CoretechR/PicoLab/firmware/html/pinout_pico2.webp

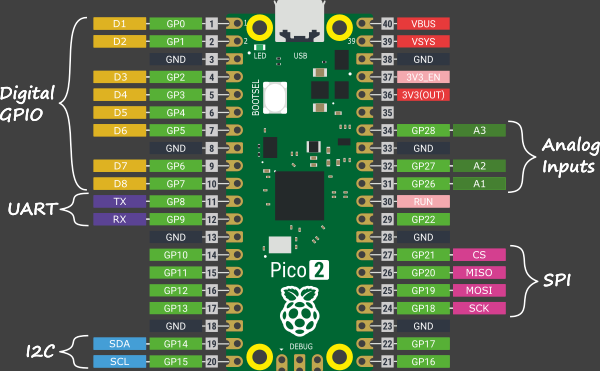
firmware/html/pinout_pico2.webp
