CoretechR/PicoLab/firmware/html/pinout_picolab.webp

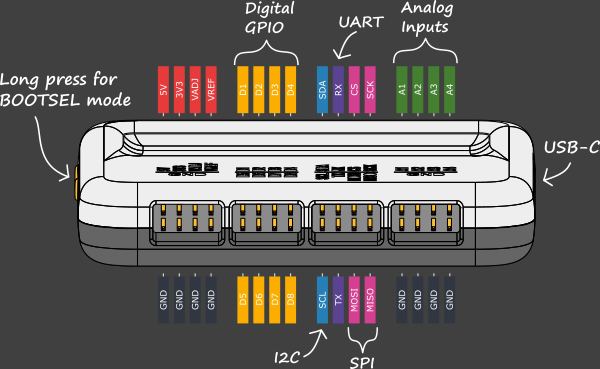
firmware/html/pinout_picolab.webp
