CoretechR/PicoLab/PCB/production/bom.csv

Designator | Footprint | Quantity | Value | LCSC Part #
C10, C11, C7, C8 | 0603 | 4 | 10nF
C12, C13, C18, C24, C27, C28, C31, C32, C33, C34, C35, C36, C37, C38, C39, C4, C40, C42, C43, C44, C45, C49, C50, C51, C52, C53, C54, C55, C56, C57, C58, C59, C60, C61, C62, C63, C64, C65, C66, C67, C68, C69, C70, C71, C72, C73, C74, C75, C76 | 0603 | 49 | 100nF | C1591
C15, C17 | 0603 | 2 | 15pF | C107037
C16, C21, C6, C9 | 0603 | 4 | 1uF | C15849
C22, C25, C26, C29 | 0603 | 4 | 4.7uF | C1705
C23, C41 | 1206 | 2 | 22uF | C91604
C46 | 1206 | 1 | 22uF
C47 | 0603 | 1 | 22nF | C106222
C48 | 0805 | 1 | 10uF
D1 | D_SOD-323 | 1 | 1N4148WS | C118873
D15 | SOT-23 | 1 | BAS70-04
D2 | LED_SK6812MINI_PLCC4_3.5x3.5mm_P1.75mm | 1 | SK6812MINI | C2886570
D3, D4, D5, D6 | SOT-23 | 4 | BAS70-04 | C54194934
D8 | D_SOD-323 | 1 | BAT54WS | C124205
F1 | 1206 | 1 | 500mA | C220146
J1 | USB_C_Receptacle_HRO_TYPE-C-31-M-12 | 1 | USB_C_Receptacle_USB2.0 | C2982555
J2 | JST_SH_SM03B-SRSS-TB_1x03-1MP_P1.00mm_Horizontal | 1 | Conn_01x03_Pin | C160403
J4, J5, J6, J7 | 10129382-908003BLF | 4 | Conn_02x04_Counter_Clockwise | C6970143
L3 | L_pol_2016 | 1 | 3.3uH | C42411119
L4 | 1008 | 1 | 4.7uH | C668313
Q10, Q15, Q16, Q17, Q18, Q4, Q6, Q8 | SOT-23 | 8 | BSS138 | C52895
Q11, Q12, Q13, Q14, Q3, Q5, Q7, Q9 | SOT-23 | 8 | DMG2301L | C7472914
R10, R11 | 0603 | 2 | 27 | C137753
R100, R101, R110, R111, R112, R113, R130, R133, R134, R138, R140, R143, R145, R148, R150, R153, R155, R158, R63, R64, R74, R77, R82, R85, R90, R93, R98, R99 | 0603 | 28 | 1M | C217860
R102, R103, R104, R105, R131, R135, R142, R147, R152, R156, R65, R75, R83, R91 | 0603 | 14 | 330
R106, R107, R108, R109, R114, R115, R116, R117, R118, R120, R122, R124, R126, R127, R128, R129, R14, R17, R27, R28, R34, R42, R46, R53, R61, R66, R67, R68, R69, R72, R76, R78, R79, R81, R84, R86, R87, R89, R9, R92, R94, R95, R97 | 0603 | 43 | 10K | C98220
R119, R121, R123, R125, R136, R139, R144, R149, R154, R159, R62, R80, R88, R96 | 0603 | 14 | 120 | C125925
R12 | 0603 | 1 | 330R | C105881
R13, R19, R22, R25 | 0603 | 4 | 300K
R15 | 0603 | 1 | 33
R16, R18, R21, R24 | 0603 | 4 | 820K
R2, R4 | 0603 | 2 | 1k | C22548
R20, R23 | 0603 | 2 | 21.5k
R26 | 0603 | 1 | 27K
R29 | 0603 | 1 | 0.5
R3, R8 | 0603 | 2 | 5.1k | C105580
R30, R31, R32, R33 | 0603 | 4 | 100 | C125923
R43, R44, R73 | 0603 | 3 | 0R03 | C422943
R49, R50 | 0603 | 2 | 4k7 | C99782
R52 | 0603 | 1 | 300K | C116699
SW1 | Panasonic_EVQPUM_EVQPUD | 1 | SW_Push | C388642
U1 | QFN-80-1EP_10x10mm_P0.4mm_EP3.4x3.4mm | 1 | RP2350_80QFN
U10 | QFN-16_3x3mm_P0.5mm_MPS | 1 | MP28167-A
U11, U4, U8 | SOT-23-5 | 3 | INA180A2 | C192764
U13, U14, U19, U20, U21, U22, U23, U24, U26, U28, U30, U31, U32, U33 | SOT-23-6 | 14 | SN74LVC1T45DBV | C7843
U15, U25, U27, U29 | SOT-23-6 | 4 | SRV05-4 | C558418
U16, U17, U18 | SOT-363_SC-70-6 | 3 | LM66100DCK | C2869734
U2 | TSSOP-14_4.4x5mm_P0.65mm | 1 | TLV9004IPWR | C2058050
U3 | WSON-8-1EP_6x5mm_P1.27mm_EP3.4x4.3mm | 1 | IS25LP064D-JKLA3-TR | C27531352
U5 | SOT-666 | 1 | USBLC6-2P6 | C2827693
U6 | SOT-23-5 | 1 | AP2112K-3.3 | C51118
U7 | SOT-23 | 1 | LM4040D30IDBZR | C130178
U9 | MSOP-8_3x3mm_P0.65mm | 1 | PI4ULS5V202 | C481697
Y1 | Crystal_SMD_Abracon_ABM8G-4Pin_3.2x2.5mm | 1 | ABM8-272-T3 | C20625731
