CoretechR/PicoLab/CAD/side_frame.stl

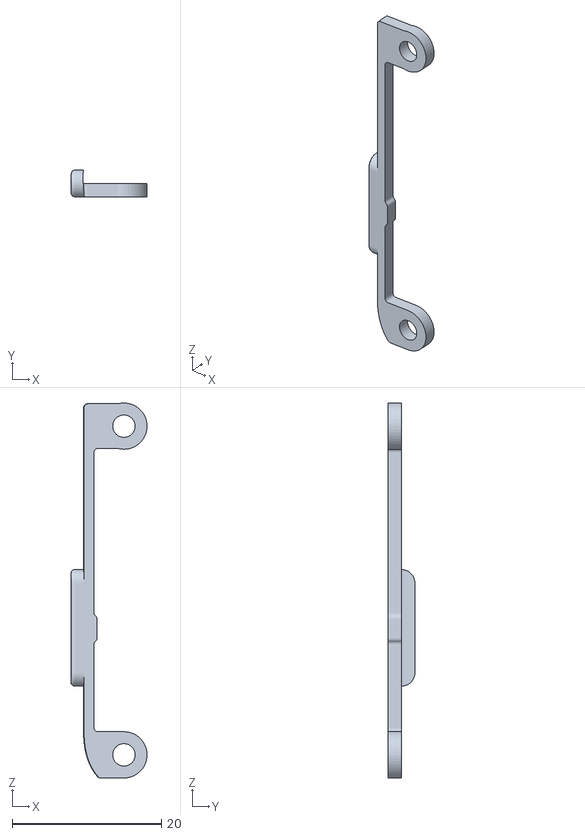
[picture p6: CAD file, 2026-10-18]
CAD/side_frame.stl
10.2 x 3.60 x 50.2
