CoretechR/PicoLab/CAD/PicoLab.step

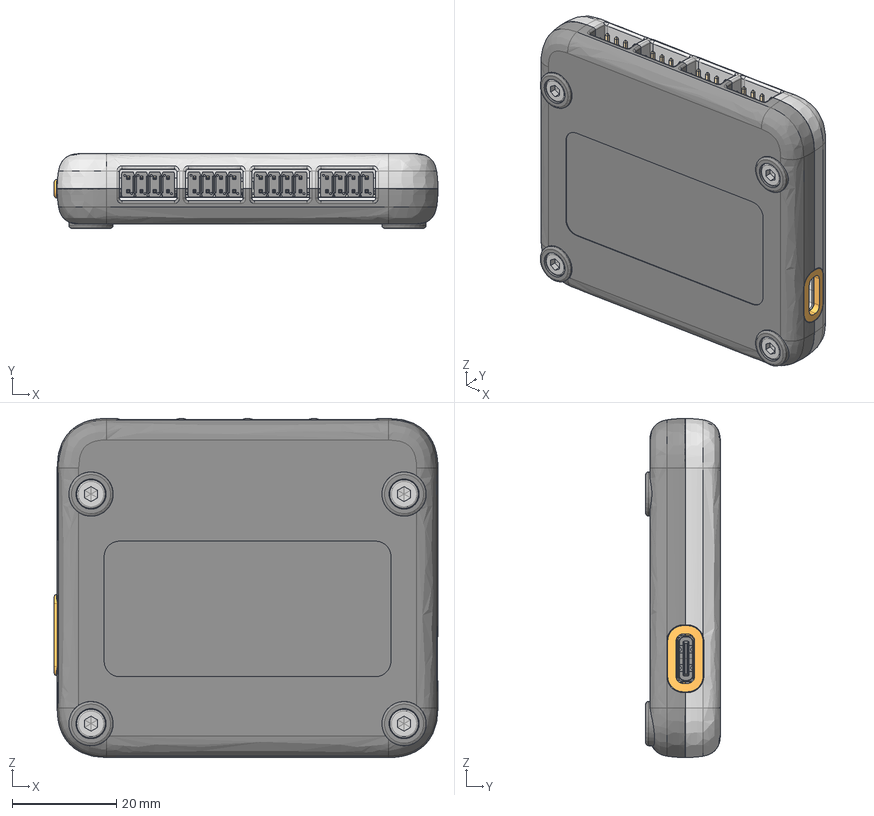
[picture p7: CAD file, 2026-10-18]
CAD/PicoLab.step
73.6 x 14.3 x 65.0 mm
BSHCS ASME B18.3.1M - M3x0.5 x 8 Stahlklasse 2 Einfach x 4
C_1206_3216Metric_1 x 3
R_0603_1608Metric_1 x 129
C_0603_1608Metric_1 x 65
USB_C_Receptacle_16P_TopMnt_Horizontal_GCT_USB4105-xx-A
QFN-16-1EP_3x3mm_P0.5mm_EP1.7x1.7mm_1
SOT-23-6_1 x 18
MSOP-8_3x3mm_P0.65mm_1
TSSOP-14_4.4x5mm_P0.65mm_1
L_Cenker_CKCS201610_1
s10129382-X08003XLF v0 x 4
SOT-363_SC-70-6_1 x 3
C_0805_2012Metric_1
WSON-8-1EP_6x5mm_P1.27mm_EP3.4x4.3mm_1
SOT-23_1 x 22
JST_SH_SM03B-SRSS-TB_1x03-1MP_P1.00mm_Horizontal_1
Crystal_SMD_Abracon_ABM8G-4Pin_3.2x2.5mm_1
SOT-23-5_1 x 4
SOT_666
Fuse_1206_3216Metric_1
D_SOD-323_1 x 2
Panasonic_EVQPUM_EVQPUD_1
rp2350text
L_1008_2520Metric_1
SK6812MINI
PicoLab_silkscreen
PicoLab_silkscreen_1
PicoLab_PCB
