CoretechR/PicoLab/PCB/project_libraries/3D-models/SK6812MINI-012.STEP

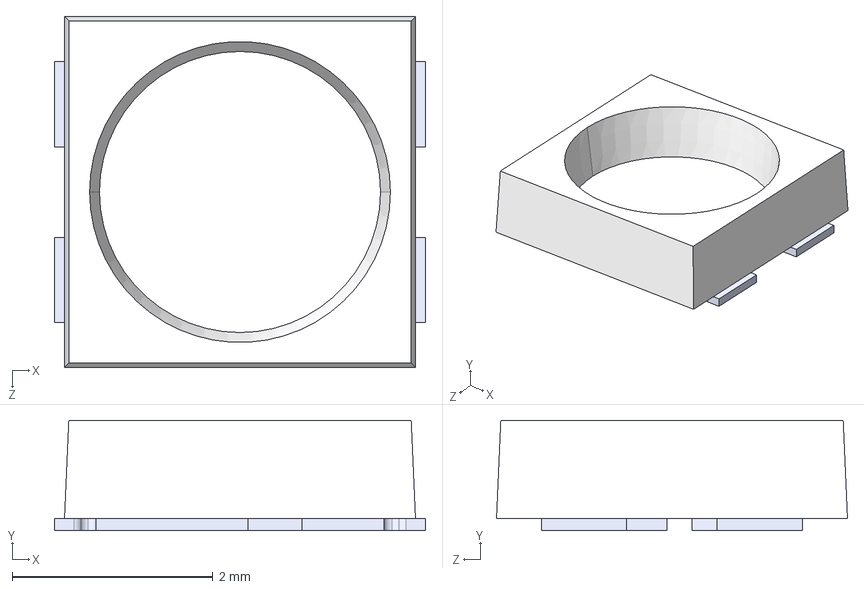
[picture p8: CAD file, 2026-10-18]
PCB/project_libraries/3D-models/SK6812MINI-012.STEP
3.70 x 1.10 x 3.50 mm
