CoretechR/PicoLab/CAD/Bottom.stl

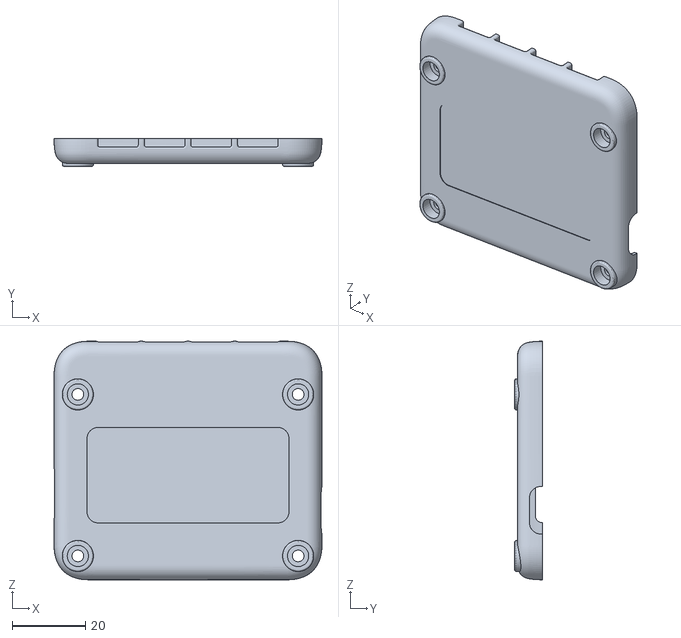
[picture p9: CAD file, 2026-10-18]
CAD/Bottom.stl
73.0 x 7.60 x 65.0
