CoretechR/PicoLab/CAD/USB_frame.stl

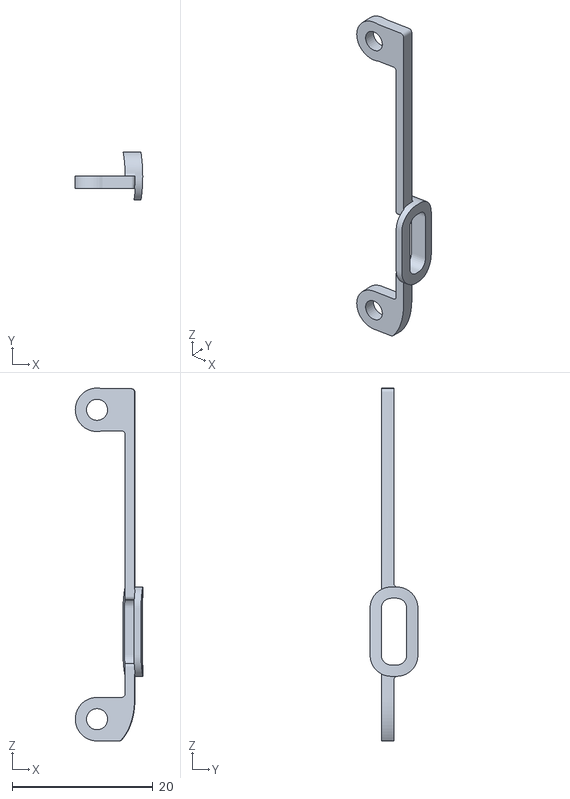
[picture p10: CAD file, 2026-10-18]
CAD/USB_frame.stl
9.60 x 6.80 x 50.2
