CoretechR/PicoLab/CAD/Top.stl

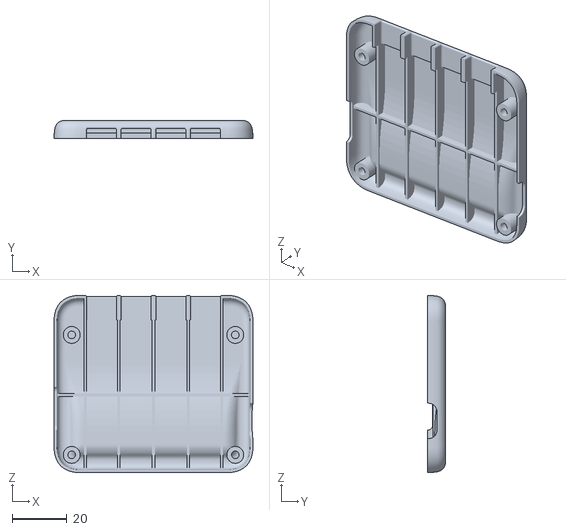
[picture p11: CAD file, 2026-10-18]
CAD/Top.stl
73.0 x 6.70 x 65.0
