CoretechR/PicoLab/PCB/project_libraries/3D-models/s10129382-X08003XLF.step

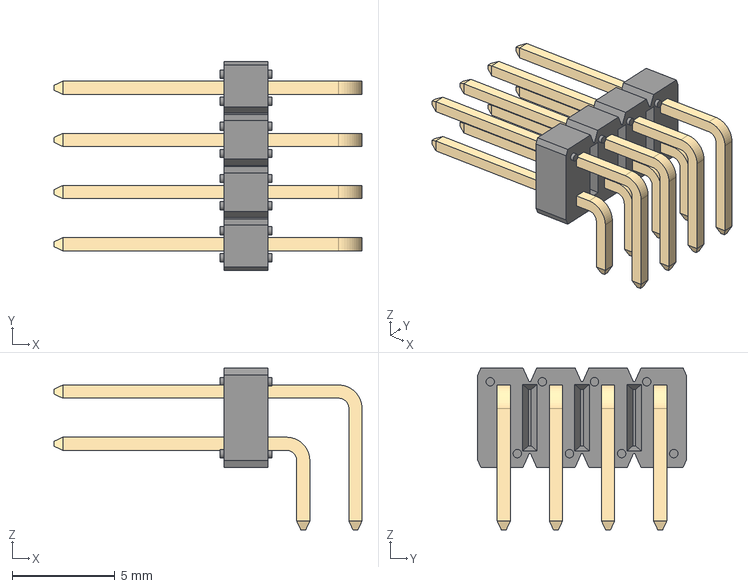
[picture p12: CAD file, 2026-10-18]
PCB/project_libraries/3D-models/s10129382-X08003XLF.step
15.0 x 10.2 x 7.88 mm
