CoretechR/PicoLab/PCB/PicoLab.pdf

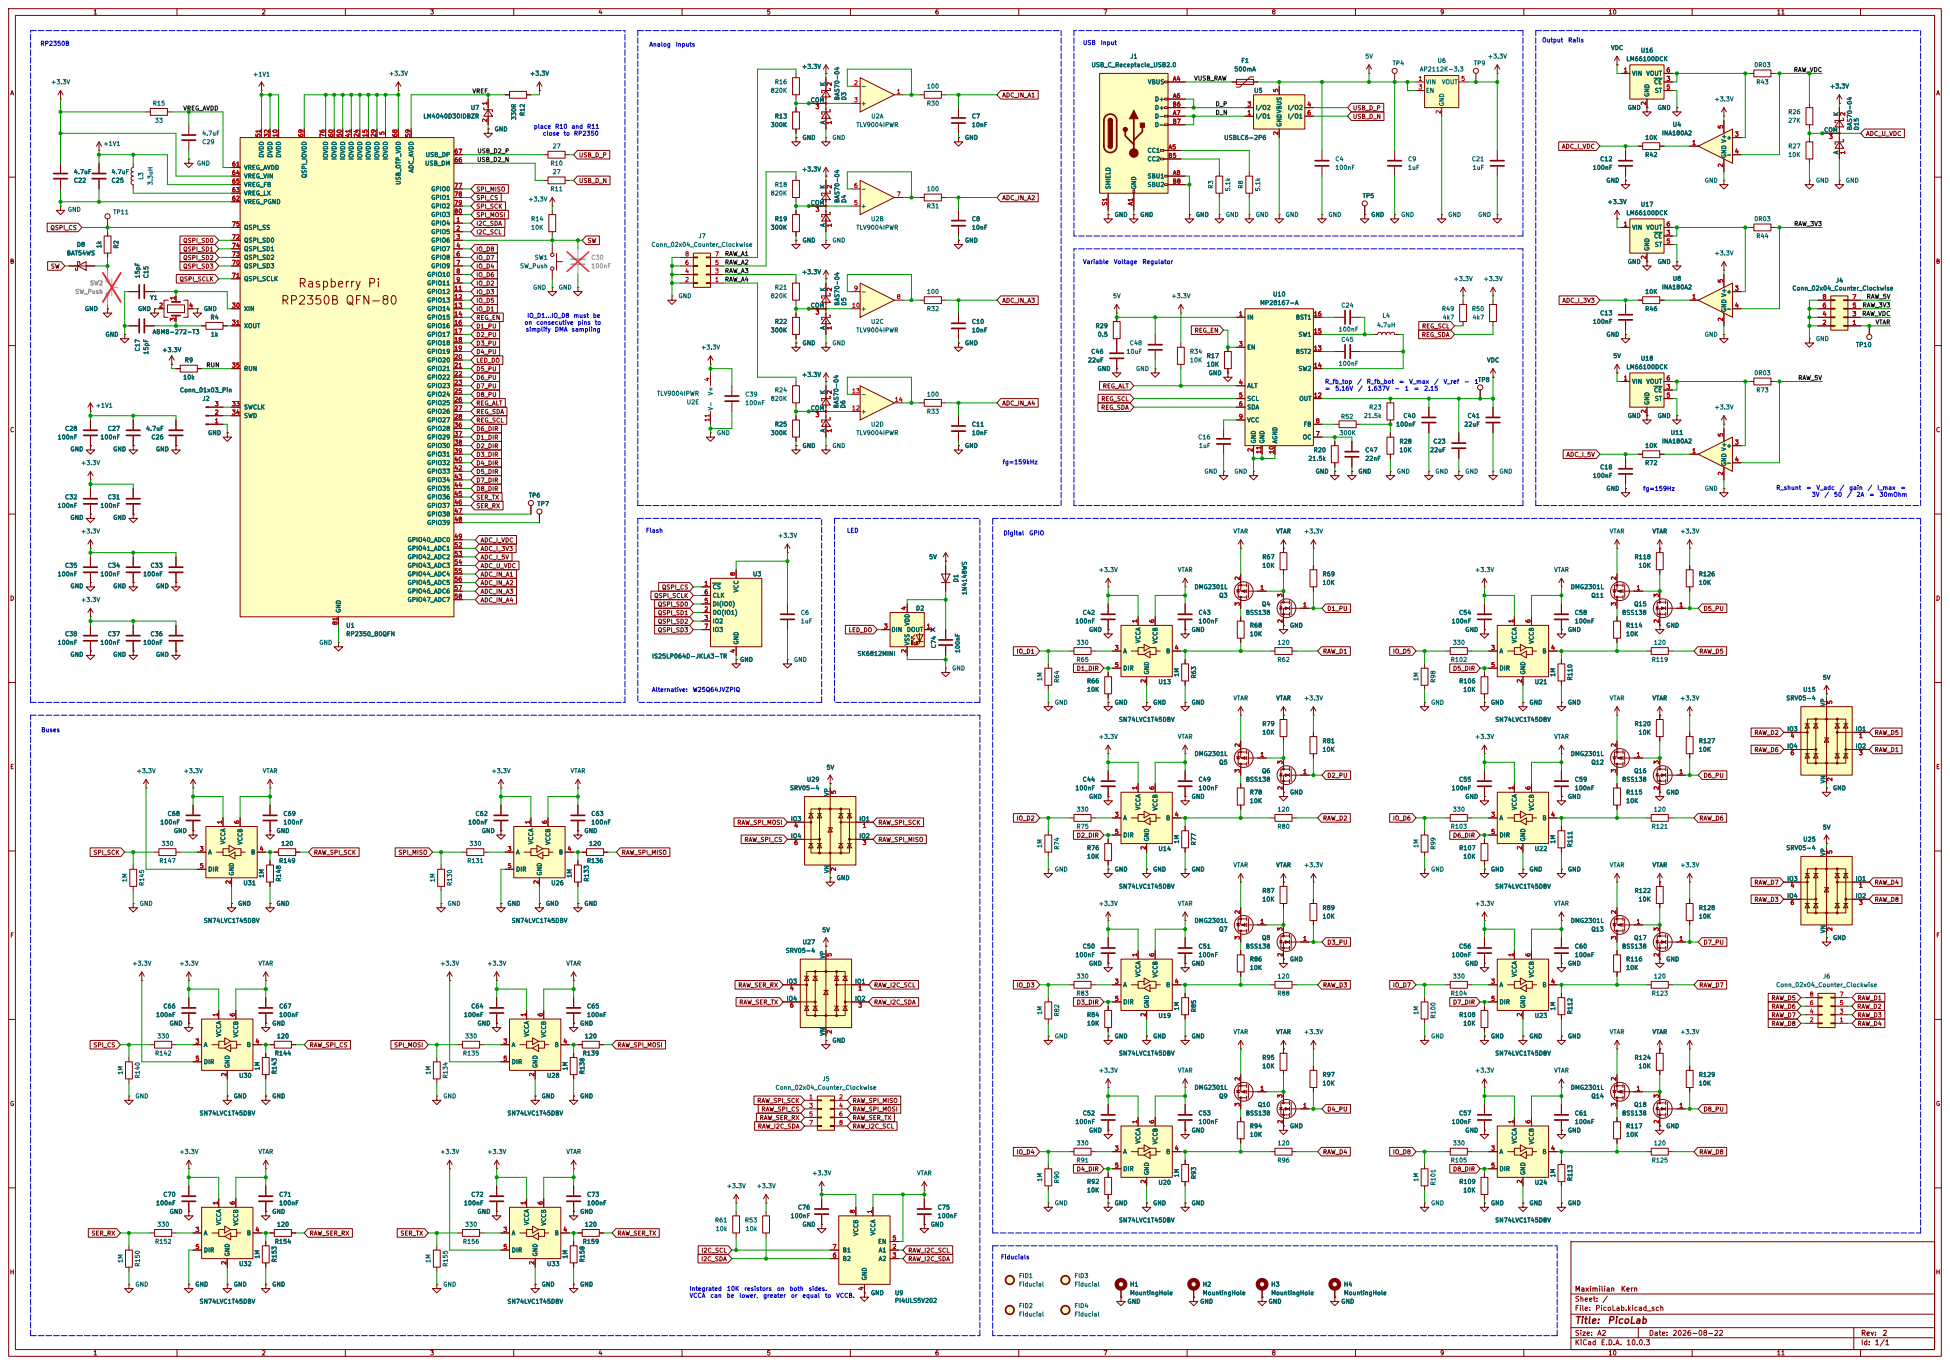
[picture p13: page 1]

5 GPIO8 6 GPIO9 7 GPIO10 8 GPIO11 9 DVDD 10 GPIO12 11 GPIO13 12 GPIO14 13 GPIO15 14 IOVDD 15 GPIO16 16 GPIO17 17 GPIO18 18 GPIO19 19 GPIO20 20 GPIO21 21 GPIO22 22 GPIO23 23 IOVDD 24 GPIO24 25 GPIO25 26 GPIO26 27 GPIO27 28 IOVDD 29

IO_D1...IO_D8 must be on consecutive pins to

Integrated 10K resistors on both sides. VCCA can be lower, greater or equal to VCCB.

GND | GND

Size: A2 | Rev: 2
KiCad E.D.A. 10.0.3 | Id: 1/1
