CoretechR/PicoLab/PCB/PicoLab.kicad_pcb

## KiCad design PCB/PicoLab.kicad_pcb (2026-10-18)

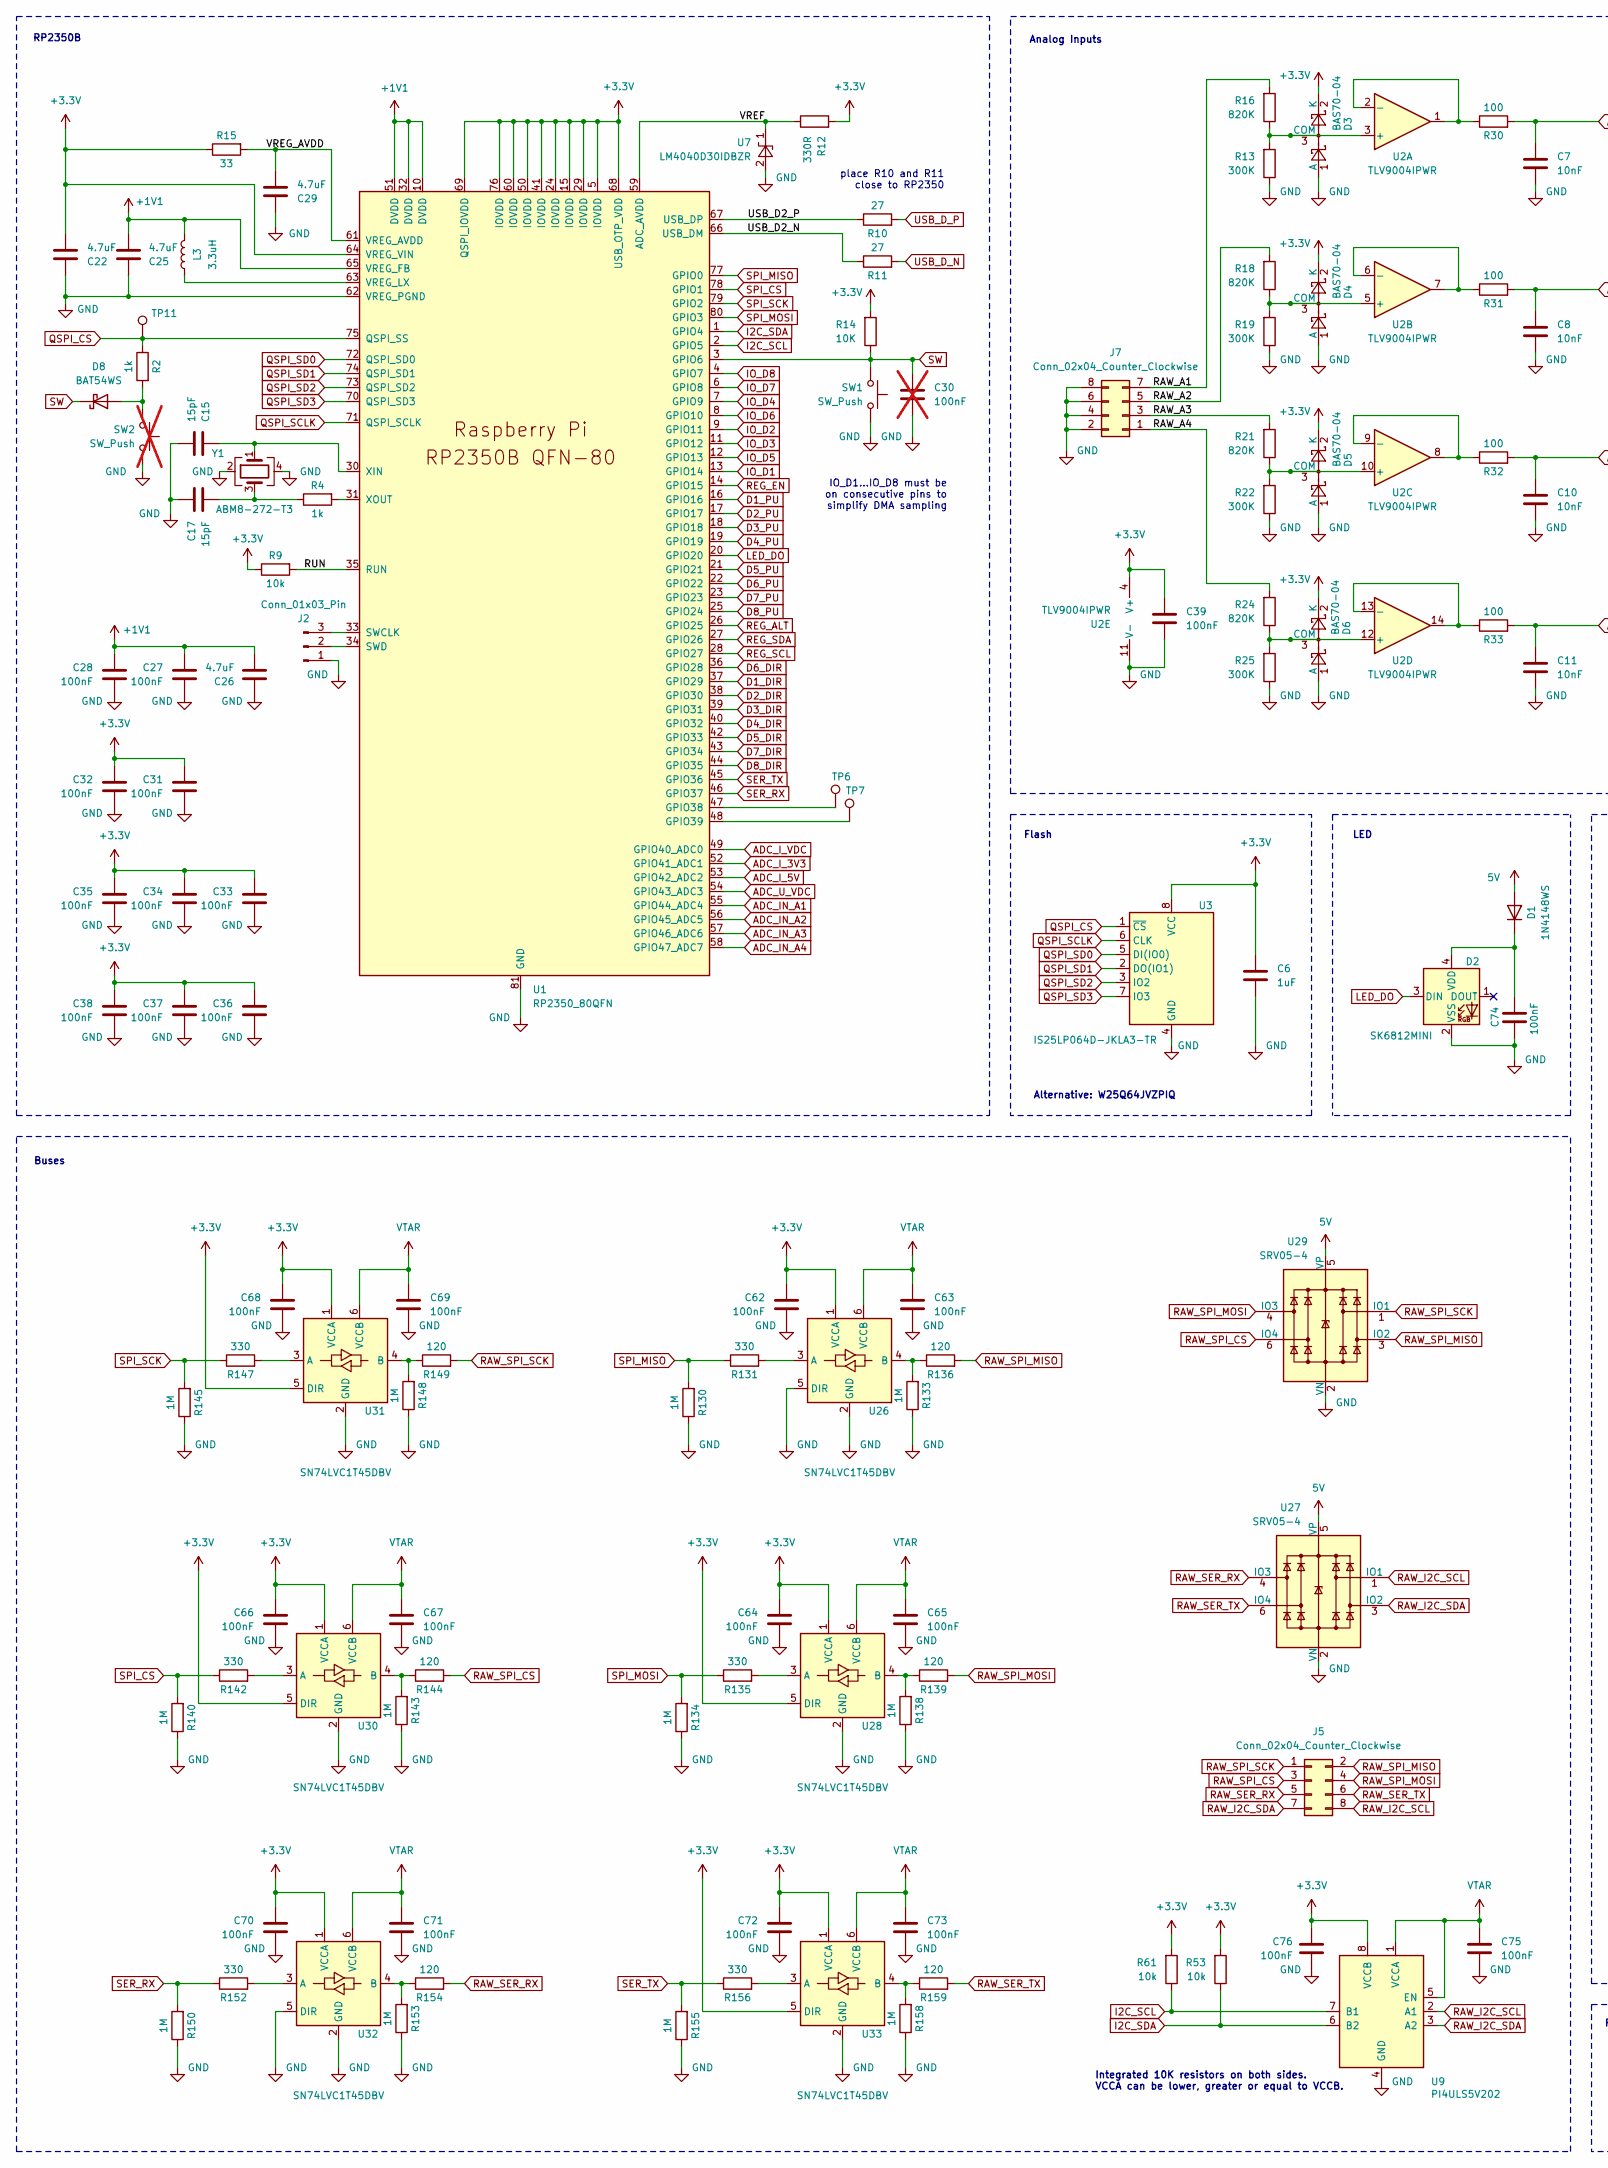
[picture p14: schematic PicoLab.kicad_sch, part in row 1, column 1]

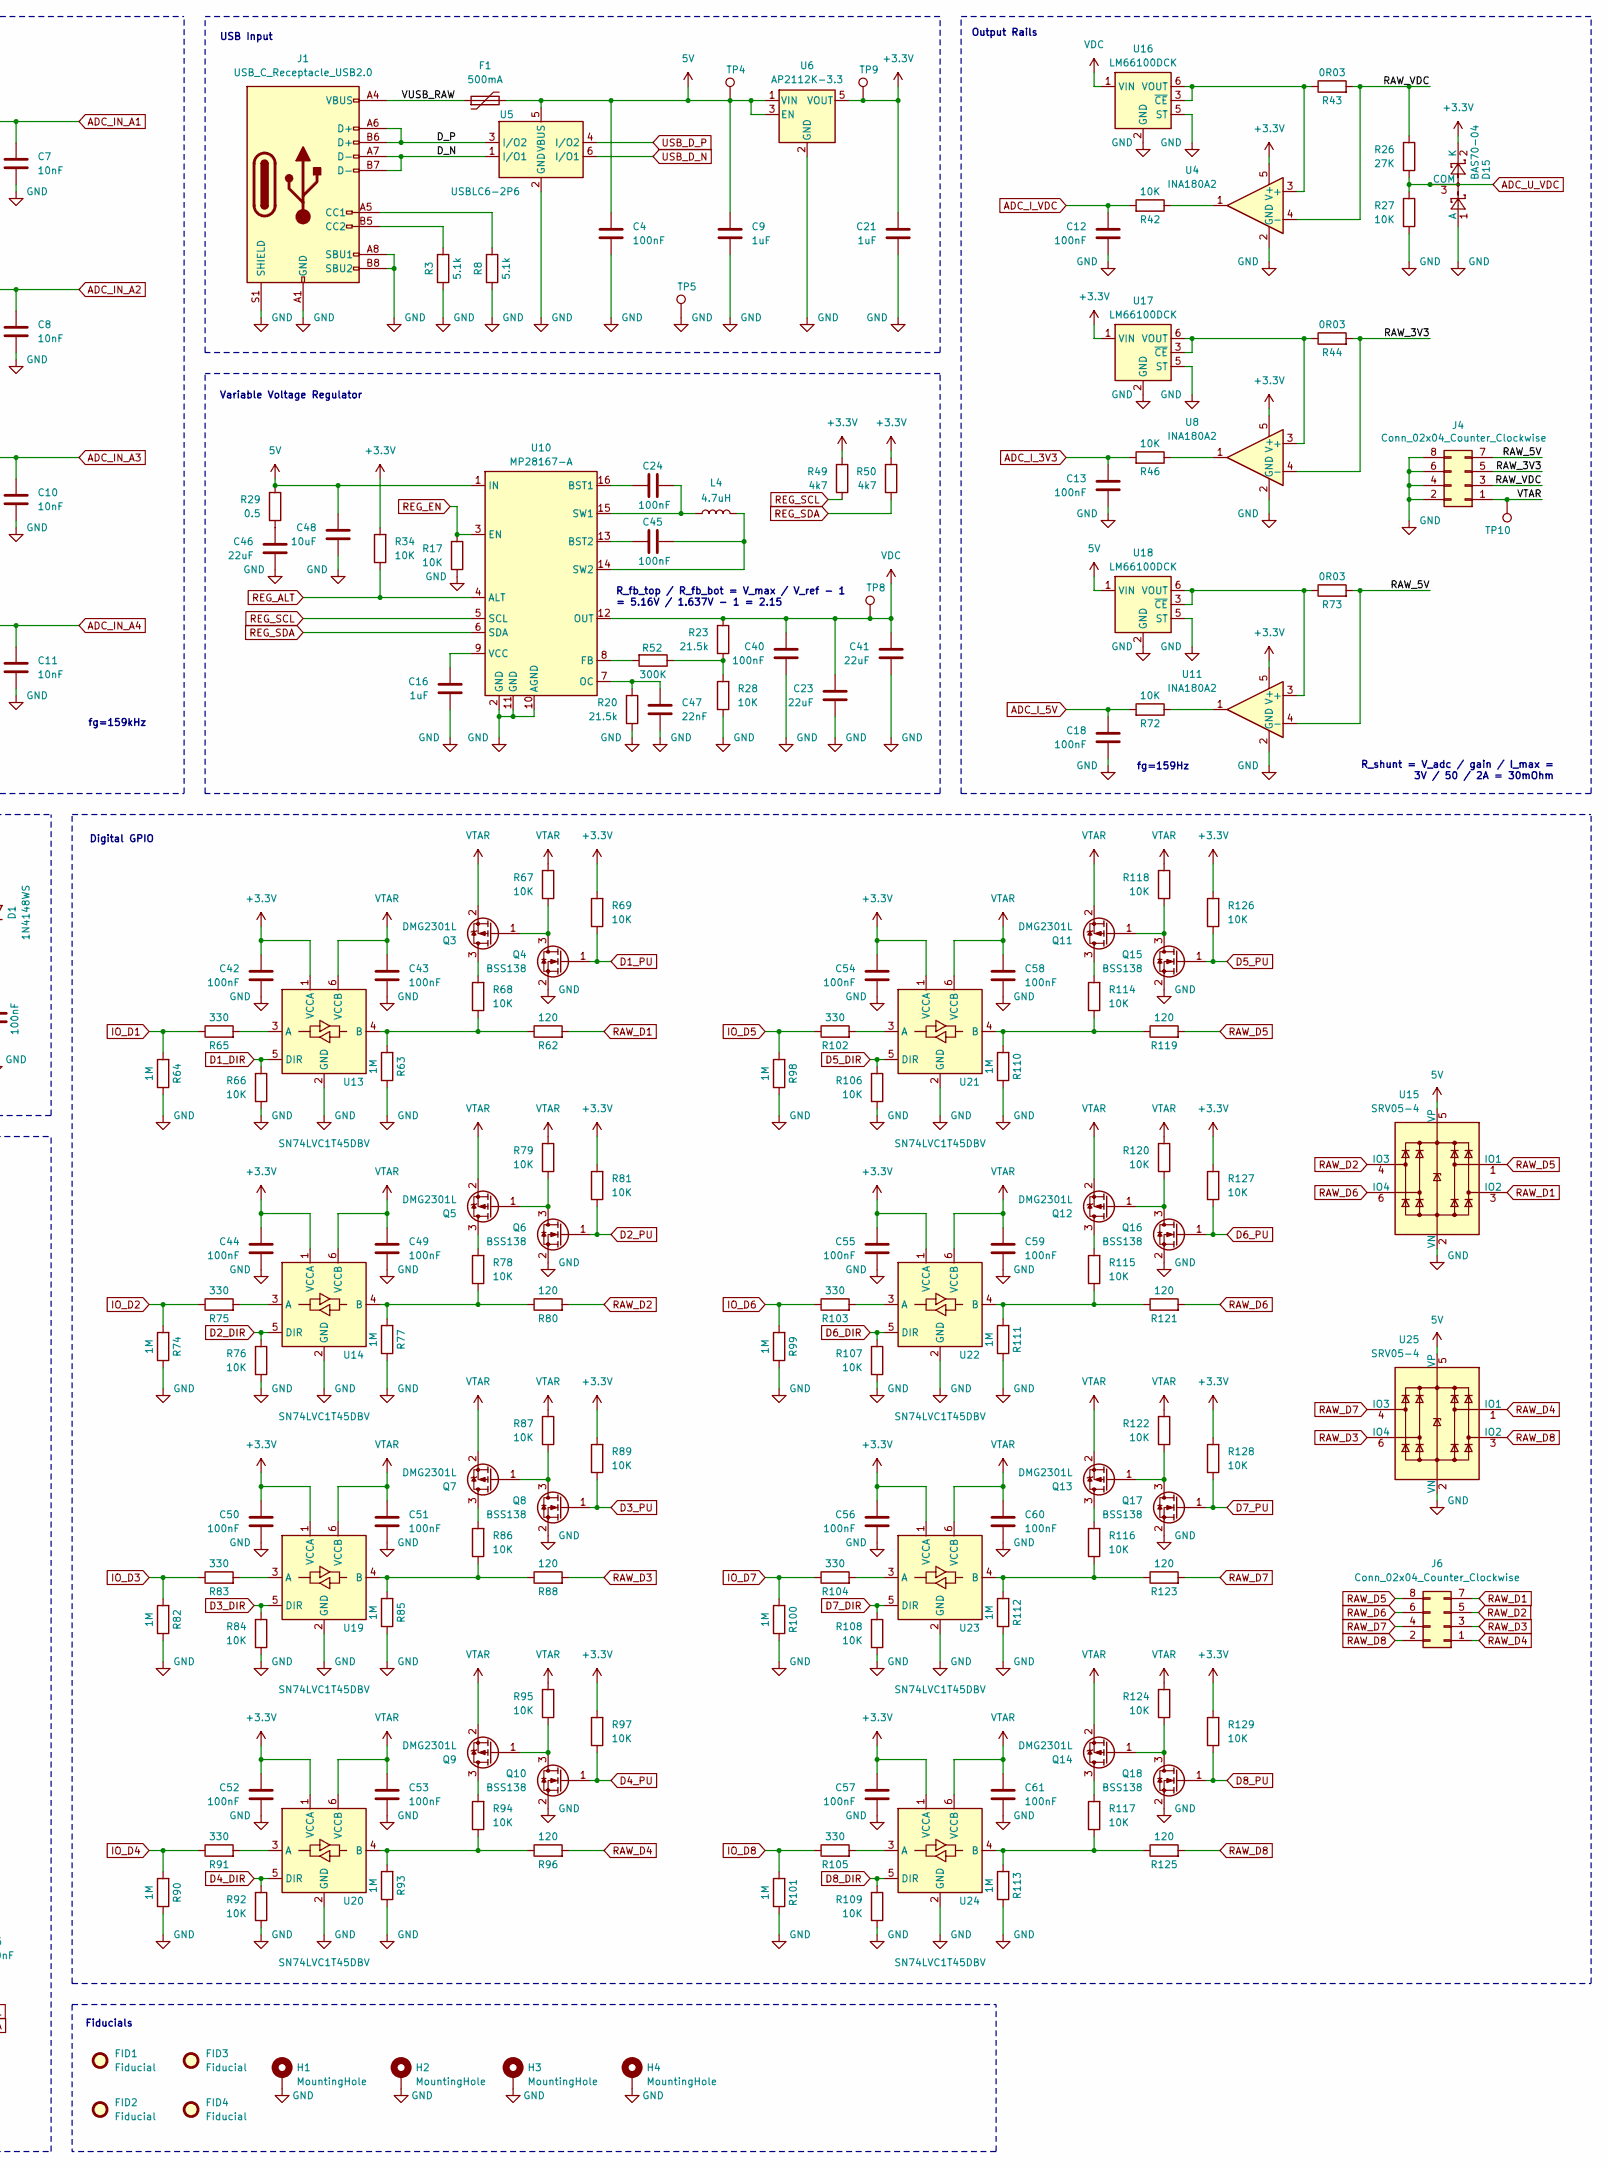
[picture p15: schematic PicoLab.kicad_sch, part in row 1, column 2]

Parts:
C4, C12, C13, C18, C24, C27, C28, C31, C32, C33, C34, C35, C36, C37, C38, C39, C40, C42, C43, C44, C45, C49, C50, C51, C52, C53, C54, C55, C56, C57, C58, C59, C60, C61, C62, C63, C64, C65, C66, C67, C68, C69, C70, C71, C72, C73, C74, C75, C76: 100nF; C_0603_1608Metric; LCSC C1591
C6, C9, C16, C21: 1uF; C_0603_1608Metric; LCSC C15849
C7, C8, C10, C11: 10nF; C_0603_1608Metric
C15, C17: 15pF; C_0603_1608Metric; LCSC C107037
C22, C25, C26, C29: 4.7uF; C_0603_1608Metric; LCSC C1705
C23, C41: 22uF; C_1206_3216Metric; LCSC C91604
C30: 100nF; C_0603_1608Metric; LCSC C1591; not fitted
C46: 22uF; C_1206_3216Metric
C47: 22nF; C_0603_1608Metric; LCSC C106222
C48: 10uF; C_0805_2012Metric
D1: 1N4148WS; D_SOD-323; LCSC C118873
D2: SK6812MINI; LED_SK6812MINI_PLCC4_3.5x3.5mm_P1.75mm; LCSC C2886570
D3, D4, D5, D6: BAS70-04; SOT-23; LCSC C54194934
D8: BAT54WS; D_SOD-323; LCSC C124205
D15: BAS70-04; SOT-23
F1: 500mA; Fuse_1206_3216Metric_Pad1.42x1.75mm_HandSolder; LCSC C220146
FID1, FID2, FID3, FID4: Fiducial; Fiducial_1mm_Mask2mm
H1, H2, H3, H4: MountingHole; MountingHole_3.2mm_M3_Pad_Via
J1: USB_C_Receptacle_USB2.0; USB_C_Receptacle_HRO_TYPE-C-31-M-12; LCSC C2982555
J2: Conn_01x03_Pin; JST_SH_SM03B-SRSS-TB_1x03-1MP_P1.00mm_Horizontal; LCSC C160403
J4, J5, J6, J7: Conn_02x04_Counter_Clockwise; 10129382-908003BLF; LCSC C6970143
L3: 3.3uH; L_pol_2016; LCSC C42411119
L4: 4.7uH; L_1008_2520Metric; LCSC C668313
Q3, Q5, Q7, Q9, Q11, Q12, Q13, Q14: DMG2301L; SOT-23; LCSC C7472914
Q4, Q6, Q8, Q10, Q15, Q16, Q17, Q18: BSS138; SOT-23; LCSC C52895
R2, R4: 1k; R_0603_1608Metric; LCSC C22548
R3, R8: 5.1k; R_0603_1608Metric; LCSC C105580
R9, R53, R61: 10k; R_0603_1608Metric; LCSC C98220
R10, R11: 27; R_0603_1608Metric; LCSC C137753
R12: 330R; R_0603_1608Metric; LCSC C105881
R13, R19, R22, R25: 300K; R_0603_1608Metric
R14, R17, R27, R28, R34, R42, R46, R66, R67, R68, R69, R72, R76, R78, R79, R81, R84, R86, R87, R89, R92, R94, R95, R97, R106, R107, R108, R109, R114, R115, R116, R117, R118, R120, R122, R124, R126, R127, R128, R129: 10K; R_0603_1608Metric; LCSC C98220
R15: 33; R_0603_1608Metric
R16, R18, R21, R24: 820K; R_0603_1608Metric
R20, R23: 21.5k; R_0603_1608Metric
R26: 27K; R_0603_1608Metric
R29: 0.5; R_0603_1608Metric
R30, R31, R32, R33: 100; R_0603_1608Metric; LCSC C125923
R43, R44, R73: 0R03; R_0603_1608Metric; LCSC C422943
R49, R50: 4k7; R_0603_1608Metric; LCSC C99782
R52: 300K; R_0603_1608Metric; LCSC C116699
R62, R80, R88, R96, R119, R121, R123, R125, R136, R139, R144, R149, R154, R159: 120; R_0603_1608Metric; LCSC C125925
R63, R64, R74, R77, R82, R85, R90, R93, R98, R99, R100, R101, R110, R111, R112, R113, R130, R133, R134, R138, R140, R143, R145, R148, R150, R153, R155, R158: 1M; R_0603_1608Metric; LCSC C217860
R65, R75, R83, R91, R102, R103, R104, R105, R131, R135, R142, R147, R152, R156: 330; R_0603_1608Metric
SW1: SW_Push; Panasonic_EVQPUM_EVQPUD; LCSC C388642
SW2: SW_Push; SW_SPST_EVQP2_ShortPushTravel_H2.1mm; LCSC C2915174; not fitted
TP4, TP5, TP6, TP7, TP8, TP9, TP10, TP11: TestPoint; TestPoint_Pad_D1.5mm
U1: RP2350_80QFN; QFN-80-1EP_10x10mm_P0.4mm_EP3.4x3.4mm
U2: TLV9004IPWR; TSSOP-14_4.4x5mm_P0.65mm; LCSC C2058050
U3: IS25LP064D-JKLA3-TR; WSON-8-1EP_6x5mm_P1.27mm_EP3.4x4.3mm; LCSC C27531352
U4, U8, U11: INA180A2; SOT-23-5; LCSC C192764
U5: USBLC6-2P6; SOT-666; LCSC C2827693
U6: AP2112K-3.3; SOT-23-5; LCSC C51118
U7: LM4040D30IDBZR; SOT-23; LCSC C130178
U9: PI4ULS5V202; MSOP-8_3x3mm_P0.65mm; LCSC C481697
U10: MP28167-A; QFN-16_3x3mm_P0.5mm_MPS
U13, U14, U19, U20, U21, U22, U23, U24, U26, U28, U30, U31, U32, U33: SN74LVC1T45DBV; SOT-23-6; LCSC C7843
U15, U25, U27, U29: SRV05-4; SOT-23-6; LCSC C558418
U16, U17, U18: LM66100DCK; SOT-363_SC-70-6; LCSC C2869734
Y1: ABM8-272-T3; Crystal_SMD_Abracon_ABM8G-4Pin_3.2x2.5mm; LCSC C20625731

Connections:
5V: C4.1, C9.1, C48.1, D1.2 (A), F1.2, R29.2, TP4.1 (1_1), U5.5 (VBUS), U6.1 (VIN), U6.3 (EN), U10.1 (IN), U15.5 (VP), U18.1 (VIN), U25.5 (VP), U27.5 (VP), U29.5 (VP)
+1V1: C25.2, C26.2, C27.1, C28.1, L3.1, U1.10 (DVDD), U1.32 (DVDD), U1.51 (DVDD), U1.65 (VREG_FB)
+3.3V: C6.1, C21.1, C22.2, C31.1, C32.1, C33.1, C34.1, C35.1, C36.1, C37.1, C38.1, C39.1, C42.1, C44.1, C50.1, C52.1, C54.1, C55.1, C56.1, C57.1, C62.1, C64.1, C66.1, C68.1, C70.1, C72.1, C76.1, D3.2 (K), D4.2 (K), D5.2 (K), D6.2 (K), D15.2 (K), R9.1, R12.2, R14.2, R15.1, R34.2, R49.2, R50.2, R53.2, R61.2, R69.2, R81.2, R89.2, R97.2, R126.2, R127.2, R128.2, R129.2, TP9.1 (1_1), U1.5 (IOVDD), U1.15 (IOVDD), U1.24 (IOVDD), U1.29 (IOVDD), U1.41 (IOVDD), U1.50 (IOVDD), U1.60 (IOVDD), U1.64 (VREG_VIN), U1.68 (USB_OTP_VDD), U1.69 (QSPI_IOVDD), U1.76 (IOVDD), U2.4 (V+), U3.8 (VCC), U4.5 (V+), U6.5 (VOUT), U8.5 (V+), U9.8 (VCCB), U11.5 (V+), U13.1 (VCCA), U14.1 (VCCA), U17.1 (VIN), U19.1 (VCCA), U20.1 (VCCA), U21.1 (VCCA), U22.1 (VCCA), U23.1 (VCCA), U24.1 (VCCA), U26.1 (VCCA), U28.1 (VCCA), U28.5 (DIR), U30.1 (VCCA), U30.5 (DIR), U31.1 (VCCA), U31.5 (DIR), U32.1 (VCCA), U33.1 (VCCA), U33.5 (DIR)
/D_N: J1.A7 (D-), J1.B7 (D-), U5.1 (I/O1)
/D_P: J1.A6 (D+), J1.B6 (D+), U5.3 (I/O2)
/RAW_3V3: J4.5, R44.2, U8.4 (-)
/RAW_5V: J4.7, R73.2, U11.4 (-)
/RAW_A1: J7.7, R16.2
/RAW_A2: J7.5, R18.2
/RAW_A3: J7.3, R21.2
/RAW_A4: J7.1, R24.2
/RAW_VDC: J4.3, R26.2, R43.2, U4.4 (-)
/RUN: R9.2, U1.35 (RUN)
/USB_D2_N: R11.1, U1.66 (USB_DM)
/USB_D2_P: R10.1, U1.67 (USB_DP)
/VREF: R12.1, U1.59 (ADC_AVDD), U7.1 (K)
/VREG_AVDD: C29.2, R15.2, U1.61 (VREG_AVDD)
/VUSB_RAW: F1.1, J1.A4 (VBUS), J1.A9 (VBUS), J1.B4 (VBUS), J1.B9 (VBUS)
ADC_IN_A1: C7.1, R30.2, U1.55 (GPIO44_ADC4)
ADC_IN_A2: C8.1, R31.2, U1.56 (GPIO45_ADC5)
ADC_IN_A3: C10.1, R32.2, U1.57 (GPIO46_ADC6)
ADC_IN_A4: C11.1, R33.2, U1.58 (GPIO47_ADC7)
ADC_I_3V3: C13.1, R46.2, U1.52 (GPIO41_ADC1)
ADC_I_5V: C18.1, R72.2, U1.53 (GPIO42_ADC2)
ADC_I_VDC: C12.1, R42.2, U1.49 (GPIO40_ADC0)
ADC_U_VDC: D15.3 (COM), R26.1, R27.2, U1.54 (GPIO43_ADC3)
D1_DIR: R66.2, U1.37 (GPIO29), U13.5 (DIR)
D1_PU: Q4.1 (G), R69.1, U1.16 (GPIO16)
D2_DIR: R76.2, U1.38 (GPIO30), U14.5 (DIR)
D2_PU: Q6.1 (G), R81.1, U1.17 (GPIO17)
D3_DIR: R84.2, U1.39 (GPIO31), U19.5 (DIR)
D3_PU: Q8.1 (G), R89.1, U1.18 (GPIO18)
D4_DIR: R92.2, U1.40 (GPIO32), U20.5 (DIR)
D4_PU: Q10.1 (G), R97.1, U1.19 (GPIO19)
D5_DIR: R106.2, U1.42 (GPIO33), U21.5 (DIR)
D5_PU: Q15.1 (G), R126.1, U1.21 (GPIO21)
D6_DIR: R107.2, U1.36 (GPIO28), U22.5 (DIR)
D6_PU: Q16.1 (G), R127.1, U1.22 (GPIO22)
D7_DIR: R108.2, U1.43 (GPIO34), U23.5 (DIR)
D7_PU: Q17.1 (G), R128.1, U1.23 (GPIO23)
D8_DIR: R109.2, U1.44 (GPIO35), U24.5 (DIR)
D8_PU: Q18.1 (G), R129.1, U1.25 (GPIO24)
GND: C4.2, C6.2, C7.2, C8.2, C9.2, C10.2, C11.2, C12.2, C13.2, C15.2, C16.2, C17.1, C18.2, C21.2, C22.1, C23.2, C25.1, C26.1, C27.2, C28.2, C29.1, C30.2, C31.2, C32.2, C33.2, C34.2, C35.2, C36.2, C37.2, C38.2, C39.2, C40.2, C41.2, C42.2, C43.2, C44.2, C46.2, C47.2, C48.2, C49.2, C50.2, C51.2, C52.2, C53.2, C54.2, C55.2, C56.2, C57.2, C58.2, C59.2, C60.2, C61.2, C62.2, C63.2, C64.2, C65.2, C66.2, C67.2, C68.2, C69.2, C70.2, C71.2, C72.2, C73.2, C74.1, C75.2, C76.2, D2.2 (VSS), D3.1 (A), D4.1 (A), D5.1 (A), D6.1 (A), D15.1 (A), H1.1 (1_1), H2.1 (1_1), H3.1 (1_1), H4.1 (1_1), J1.A1 (GND), J1.A8 (SBU1), J1.A12 (GND), J1.B1 (GND), J1.B8 (SBU2), J1.B12 (GND), J1.S1 (SHIELD), J2.1, J4.2, J4.4, J4.6, J4.8, J7.2, J7.4, J7.6, J7.8, Q4.2 (S), Q6.2 (S), Q8.2 (S), Q10.2 (S), Q15.2 (S), Q16.2 (S), Q17.2 (S), Q18.2 (S), R3.1, R8.1, R13.1, R17.1, R19.1, R20.1, R22.1, R25.1, R27.1, R28.1, R63.1, R64.1, R66.1, R74.1, R76.1, R77.1, R82.1, R84.1, R85.1, R90.1, R92.1, R93.1, R98.1, R99.1, R100.1, R101.1, R106.1, R107.1, R108.1, R109.1, R110.1, R111.1, R112.1, R113.1, R130.1, R133.1, R134.1, R138.1, R140.1, R143.1, R145.1, R148.1, R150.1, R153.1, R155.1, R158.1, SW1.1, SW2.1, TP5.1 (1_1), U1.62 (VREG_PGND), U1.81 (GND), U2.11 (V-), U3.4 (GND), U4.2 (GND), U5.2 (GND), U6.2 (GND), U7.2 (A), U8.2 (GND), U9.4 (GND), U10.2 (GND), U10.10 (AGND), U10.11 (GND), U11.2 (GND), U13.2 (GND), U14.2 (GND), U15.2 (VN), U16.2 (GND), U16.5 (ST), U17.2 (GND), U17.5 (ST), U18.2 (GND), U18.5 (ST), U19.2 (GND), U20.2 (GND), U21.2 (GND), U22.2 (GND), U23.2 (GND), U24.2 (GND), U25.2 (VN), U26.2 (GND), U26.5 (DIR), U27.2 (VN), U28.2 (GND), U29.2 (VN), U30.2 (GND), U31.2 (GND), U32.2 (GND), U32.5 (DIR), U33.2 (GND), Y1.2, Y1.4
I2C_SCL: R61.1, U1.2 (GPIO5), U9.7 (B1)
I2C_SDA: R53.1, U1.1 (GPIO4), U9.6 (B2)
IO_D1: R64.2, R65.1, U1.13 (GPIO14)
IO_D2: R74.2, R75.1, U1.9 (GPIO11)
IO_D3: R82.2, R83.1, U1.11 (GPIO12)
IO_D4: R90.2, R91.1, U1.7 (GPIO9)
IO_D5: R98.2, R102.1, U1.12 (GPIO13)
IO_D6: R99.2, R103.1, U1.8 (GPIO10)
IO_D7: R100.2, R104.1, U1.6 (GPIO8)
IO_D8: R101.2, R105.1, U1.4 (GPIO7)
LED_DO: D2.3 (DIN), U1.20 (GPIO20)
unnamed: C17.2, R4.1, Y1.3
unnamed: C46.1, R29.1
unnamed: C74.2, D1.1 (K), D2.4 (VDD)
unnamed: D3.3 (COM), R13.2, R16.1, U2.3 (+)
unnamed: D4.3 (COM), R18.1, R19.2, U2.5 (+)
unnamed: D5.3 (COM), R21.1, R22.2, U2.10 (+)
unnamed: D6.3 (COM), R24.1, R25.2, U2.12 (+)
unnamed: D8.2 (A), R2.2, SW2.2
unnamed: J1.A5 (CC1), R8.2
unnamed: J1.B5 (CC2), R3.2
unnamed: J2.2, U1.34 (SWD)
unnamed: J2.3, U1.33 (SWCLK)
unnamed: Q3.3 (D), R68.2
unnamed: Q3.1 (G), Q4.3 (D), R67.1
unnamed: Q5.3 (D), R78.2
unnamed: Q5.1 (G), Q6.3 (D), R79.1
unnamed: Q7.3 (D), R86.2
unnamed: Q7.1 (G), Q8.3 (D), R87.1
unnamed: Q9.3 (D), R94.2
unnamed: Q9.1 (G), Q10.3 (D), R95.1
unnamed: Q11.3 (D), R114.2
unnamed: Q11.1 (G), Q15.3 (D), R118.1
unnamed: Q12.3 (D), R115.2
unnamed: Q12.1 (G), Q16.3 (D), R120.1
unnamed: Q13.3 (D), R116.2
unnamed: Q13.1 (G), Q17.3 (D), R122.1
unnamed: Q14.3 (D), R117.2
unnamed: Q14.1 (G), Q18.3 (D), R124.1
unnamed: R23.1, R28.2, R52.1
unnamed: R42.1, U4.1
unnamed: R46.1, U8.1
unnamed: R72.1, U11.1
unnamed: TP6.1 (1_1), U1.47 (GPIO38)
unnamed: TP7.1 (1_1), U1.48 (GPIO39)
unnamed: L3.2, U1.63 (VREG_LX)
unnamed: C15.1, U1.30 (XIN), Y1.1
unnamed: R4.2, U1.31 (XOUT)
unnamed: R30.1, U2.1, U2.2 (-)
unnamed: R31.1, U2.6 (-), U2.7
unnamed: R32.1, U2.8, U2.9 (-)
unnamed: R33.1, U2.13 (-), U2.14
unnamed: C24.2, U10.16 (BST1)
unnamed: C45.2, U10.13 (BST2)
unnamed: R52.2, U10.8 (FB)
unnamed: C47.1, R20.2, U10.7 (OC)
unnamed: C24.1, L4.2, U10.15 (SW1)
unnamed: C45.1, L4.1, U10.14 (SW2)
unnamed: C16.1, U10.9 (VCC)
unnamed: R73.1, U11.3 (+), U18.3 (~CE), U18.6 (VOUT)
unnamed: R65.2, U13.3 (A)
unnamed: R62.1, R63.2, R68.1, U13.4 (B)
unnamed: R75.2, U14.3 (A)
unnamed: R77.2, R78.1, R80.1, U14.4 (B)
unnamed: R43.1, U4.3 (+), U16.3 (~CE), U16.6 (VOUT)
unnamed: R44.1, U8.3 (+), U17.3 (~CE), U17.6 (VOUT)
unnamed: R83.2, U19.3 (A)
unnamed: R85.2, R86.1, R88.1, U19.4 (B)
unnamed: R91.2, U20.3 (A)
unnamed: R93.2, R94.1, R96.1, U20.4 (B)
unnamed: R102.2, U21.3 (A)
unnamed: R110.2, R114.1, R119.1, U21.4 (B)
unnamed: R103.2, U22.3 (A)
unnamed: R111.2, R115.1, R121.1, U22.4 (B)
unnamed: R104.2, U23.3 (A)
unnamed: R112.2, R116.1, R123.1, U23.4 (B)
unnamed: R105.2, U24.3 (A)
unnamed: R113.2, R117.1, R125.1, U24.4 (B)
unnamed: R131.2, U26.3 (A)
unnamed: R133.2, R136.1, U26.4 (B)
unnamed: R135.2, U28.3 (A)
unnamed: R138.2, R139.1, U28.4 (B)
unnamed: R142.2, U30.3 (A)
unnamed: R143.2, R144.1, U30.4 (B)
unnamed: R147.2, U31.3 (A)
unnamed: R148.2, R149.1, U31.4 (B)
unnamed: R152.2, U32.3 (A)
unnamed: R153.2, R154.1, U32.4 (B)
unnamed: R156.2, U33.3 (A)
unnamed: R158.2, R159.1, U33.4 (B)
QSPI_CS: R2.1, TP11.1 (1_1), U1.75 (QSPI_SS), U3.1 (~CS)
QSPI_SCLK: U1.71 (QSPI_SCLK), U3.6 (CLK)
QSPI_SD0: U1.72 (QSPI_SD0), U3.5 (DI(IO0))
QSPI_SD1: U1.74 (QSPI_SD1), U3.2 (DO(IO1))
QSPI_SD2: U1.73 (QSPI_SD2), U3.3 (IO2)
QSPI_SD3: U1.70 (QSPI_SD3), U3.7 (IO3)
RAW_D1: J6.7, R62.2, U15.3 (IO2)
RAW_D2: J6.5, R80.2, U15.4 (IO3)
RAW_D3: J6.3, R88.2, U25.6 (IO4)
RAW_D4: J6.1, R96.2, U25.1 (IO1)
RAW_D5: J6.8, R119.2, U15.1 (IO1)
RAW_D6: J6.6, R121.2, U15.6 (IO4)
RAW_D7: J6.4, R123.2, U25.4 (IO3)
RAW_D8: J6.2, R125.2, U25.3 (IO2)
RAW_I2C_SCL: J5.8, U9.2 (A1), U27.1 (IO1)
RAW_I2C_SDA: J5.7, U9.3 (A2), U27.3 (IO2)
RAW_SER_RX: J5.5, R154.2, U27.4 (IO3)
RAW_SER_TX: J5.6, R159.2, U27.6 (IO4)
RAW_SPI_CS: J5.3, R144.2, U29.6 (IO4)
RAW_SPI_MISO: J5.2, R136.2, U29.3 (IO2)
RAW_SPI_MOSI: J5.4, R139.2, U29.4 (IO3)
RAW_SPI_SCK: J5.1, R149.2, U29.1 (IO1)
REG_ALT: R34.1, U1.26 (GPIO25), U10.4 (ALT)
REG_EN: R17.2, U1.14 (GPIO15), U10.3 (EN)
REG_SCL: R49.1, U1.28 (GPIO27), U10.5 (SCL)
REG_SDA: R50.1, U1.27 (GPIO26), U10.6 (SDA)
SER_RX: R150.2, R152.1, U1.46 (GPIO37)
SER_TX: R155.2, R156.1, U1.45 (GPIO36)
SPI_CS: R140.2, R142.1, U1.78 (GPIO1)
SPI_MISO: R130.2, R131.1, U1.77 (GPIO0)
SPI_MOSI: R134.2, R135.1, U1.80 (GPIO3)
SPI_SCK: R145.2, R147.1, U1.79 (GPIO2)
SW: C30.1, D8.1 (K), R14.1, SW1.2, U1.3 (GPIO6)
USB_D_N: R11.2, U5.6 (I/O1)
USB_D_P: R10.2, U5.4 (I/O2)
VDC: C23.1, C40.1, C41.1, R23.2, TP8.1 (1_1), U10.12 (OUT), U16.1 (VIN)
VTAR: C43.1, C49.1, C51.1, C53.1, C58.1, C59.1, C60.1, C61.1, C63.1, C65.1, C67.1, C69.1, C71.1, C73.1, C75.1, J4.1, Q3.2 (S), Q5.2 (S), Q7.2 (S), Q9.2 (S), Q11.2 (S), Q12.2 (S), Q13.2 (S), Q14.2 (S), R67.2, R79.2, R87.2, R95.2, R118.2, R120.2, R122.2, R124.2, TP10.1 (1_1), U9.1 (VCCA), U9.5 (EN), U13.6 (VCCB), U14.6 (VCCB), U19.6 (VCCB), U20.6 (VCCB), U21.6 (VCCB), U22.6 (VCCB), U23.6 (VCCB), U24.6 (VCCB), U26.6 (VCCB), U28.6 (VCCB), U30.6 (VCCB), U31.6 (VCCB), U32.6 (VCCB), U33.6 (VCCB)

Notes on the sheet:
RP2350B
place R10 and R11 close to RP2350
Variable Voltage Regulator
R_shunt = V_adc / gain / I_max = 3V / 50 / 2A = 30mOhm
Alternative: W25Q64JVZPIQ
R_fb_top / R_fb_bot = V_max / V_ref - 1 = 5.16V / 1.637V - 1 = 2.15
Flash
Analog Inputs
fg=159Hz
fg=159kHz
Buses
Output Rails
LED
Digital GPIO
Fiducials
Integrated 10K resistors on both sides. VCCA can be lower, greater or equal to VCCB.
IO_D1...IO_D8 must be on consecutive pins to simplify DMA sampling
USB Input

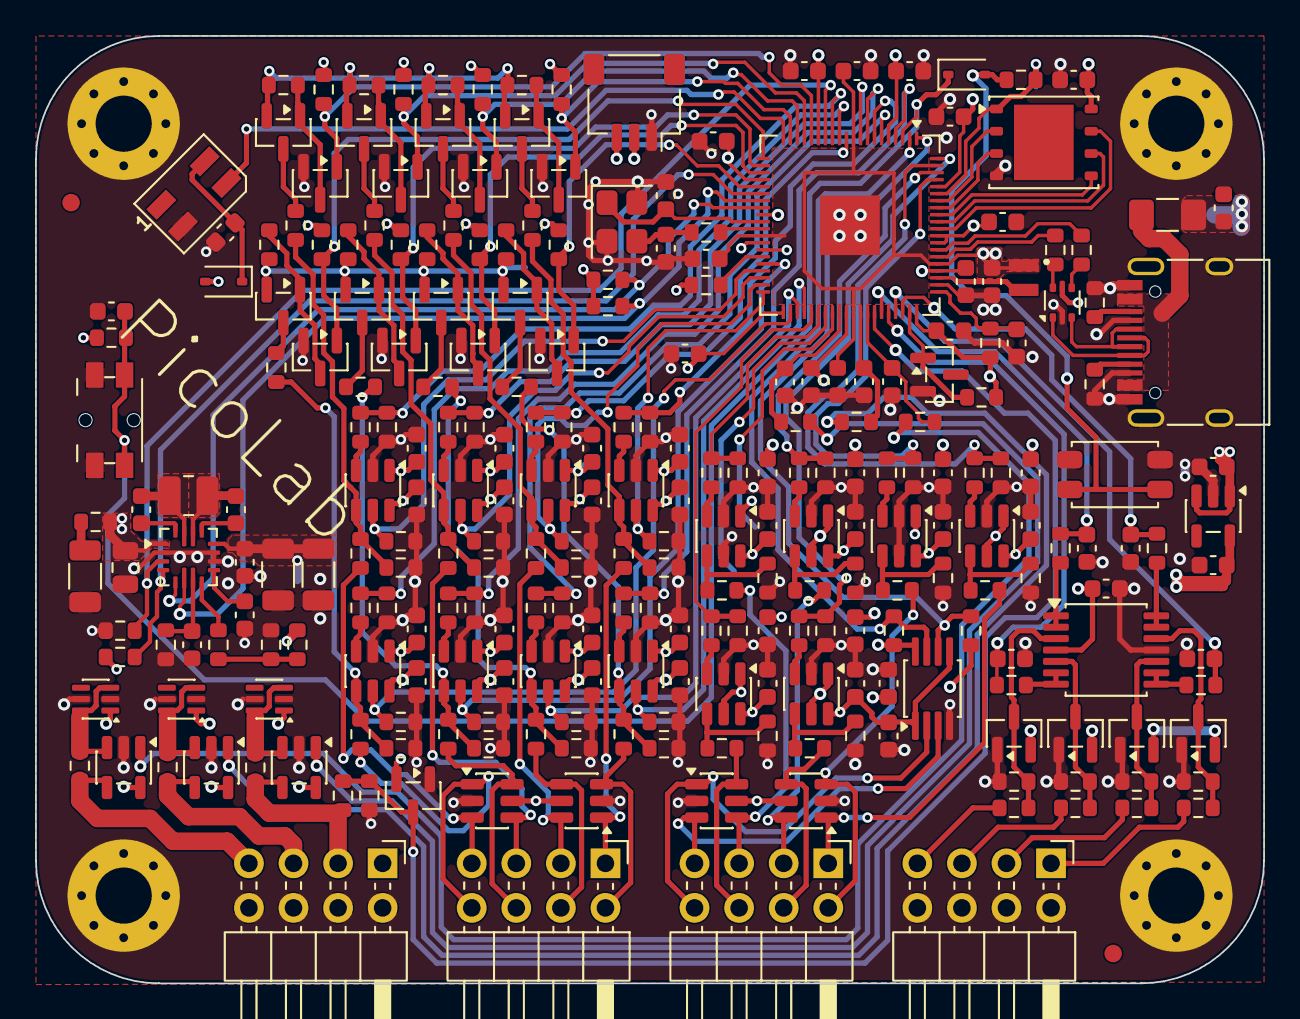
[picture p16: board PicoLab.kicad_pcb from above]

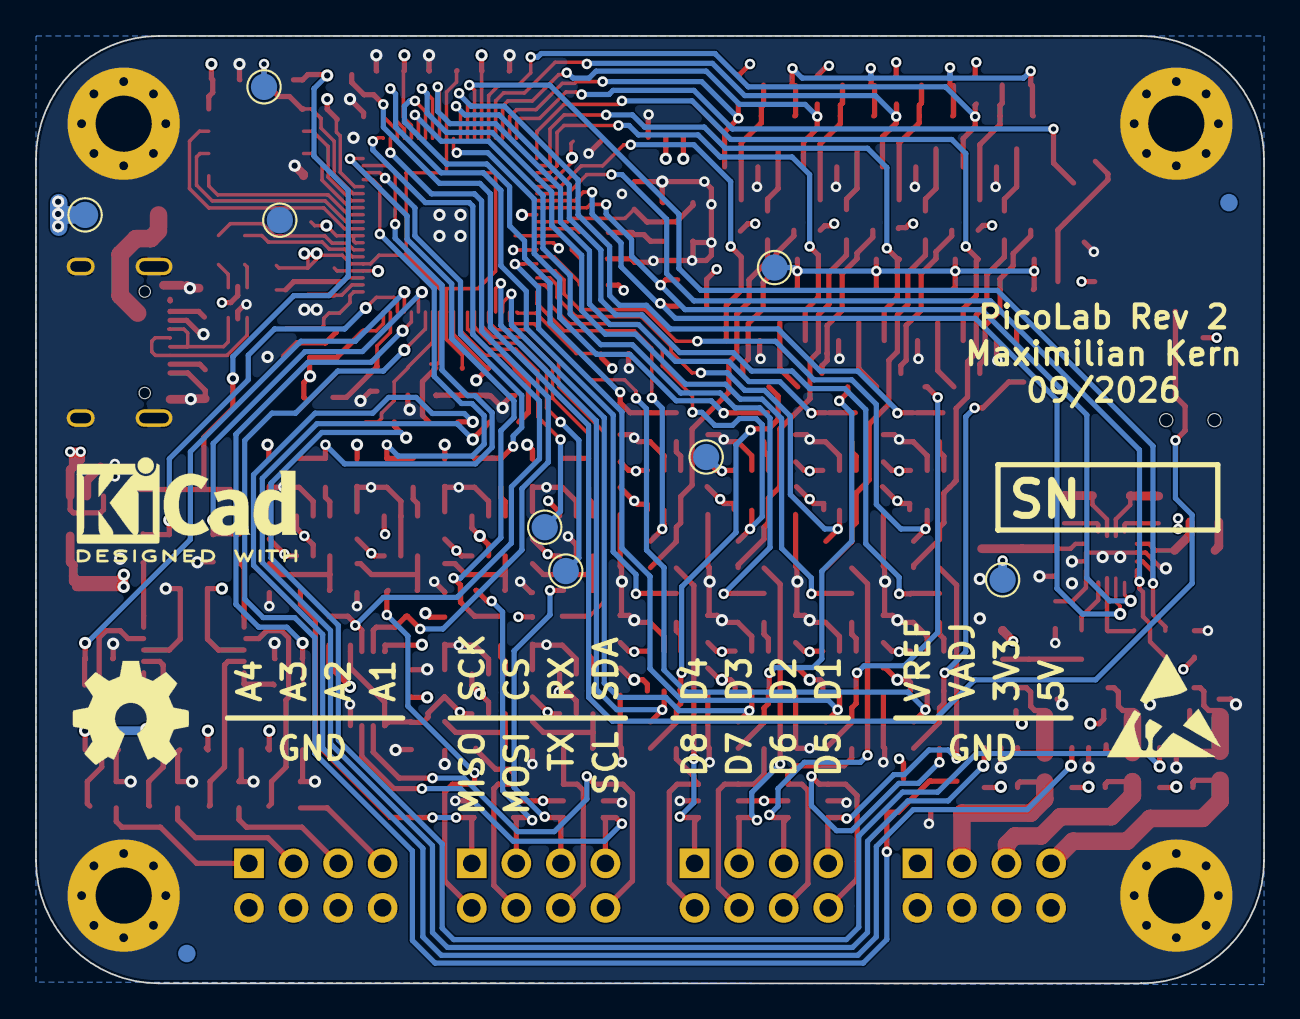
[picture p17: board PicoLab.kicad_pcb from below]

Board: 4 copper layers, 70.0 x 54.0 mm, 282 parts (10 on the bottom side), 170 nets.
