CoretechR/PicoLab/firmware/board_config.h

#ifndef BOARD_CONFIG_H
#define BOARD_CONFIG_H

#include <stdint.h>

#define HW_PICO 1
#define HW_PICOLAB_REV1 2
#define HW_PICOLAB_REV2 3

// Select target hardware here: HW_PICO, HW_PICOLAB_REV1, or HW_PICOLAB_REV2.
#ifndef PICOLAB_HW_TARGET
#define PICOLAB_HW_TARGET HW_PICOLAB_REV2
#endif

#define PICOLAB_NUM_DIGITAL_PINS 8
#define PICOLAB_NUM_ANALOG_CHANNELS 4
#define PICOLAB_UNUSED_PIN 0xFFu
#define PICOLAB_UNUSED_ADC 0xFFu

#if PICOLAB_HW_TARGET == HW_PICO

#define PICOLAB_BOARD_NAME "Raspberry Pi Pico"

static const uint8_t PICOLAB_MANAGED_PINS[PICOLAB_NUM_DIGITAL_PINS] = {0, 1, 2, 3, 4, 5, 6, 7};
static const uint8_t PICOLAB_DIR_CTRL_PINS[PICOLAB_NUM_DIGITAL_PINS] = {
    PICOLAB_UNUSED_PIN, PICOLAB_UNUSED_PIN, PICOLAB_UNUSED_PIN, PICOLAB_UNUSED_PIN,
    PICOLAB_UNUSED_PIN, PICOLAB_UNUSED_PIN, PICOLAB_UNUSED_PIN, PICOLAB_UNUSED_PIN
};
static const uint8_t PICOLAB_PULLUP_CTRL_PINS[PICOLAB_NUM_DIGITAL_PINS] = {
    PICOLAB_UNUSED_PIN, PICOLAB_UNUSED_PIN, PICOLAB_UNUSED_PIN, PICOLAB_UNUSED_PIN,
    PICOLAB_UNUSED_PIN, PICOLAB_UNUSED_PIN, PICOLAB_UNUSED_PIN, PICOLAB_UNUSED_PIN
};

#define PICOLAB_HAS_EXT_DIR_CTRL 0
#define PICOLAB_HAS_EXT_PULLUP_CTRL 0
#define PICOLAB_DIR_OUT_LEVEL 1
#define PICOLAB_PULLUP_ENABLE_LEVEL 1
#define PICOLAB_LOGIC_BASE_PIN 0

#define PICOLAB_UART_ID uart1
#define PICOLAB_UART_TX_PIN 8
#define PICOLAB_UART_RX_PIN 9
#define PICOLAB_UART_BAUD_RATE 115200

#define PICOLAB_SPI_ID spi0
#define PICOLAB_SPI_SCK_PIN 18
#define PICOLAB_SPI_MOSI_PIN 19
#define PICOLAB_SPI_MISO_PIN 20
#define PICOLAB_SPI_DEFAULT_CS_PIN 21

#define PICOLAB_I2C0_ID i2c1
#define PICOLAB_I2C0_SDA_PIN 14
#define PICOLAB_I2C0_SCL_PIN 15

static const uint8_t PICOLAB_ADC_INPUTS[PICOLAB_NUM_ANALOG_CHANNELS] = {0, 1, 2, PICOLAB_UNUSED_ADC};
static const uint8_t PICOLAB_ADC_GPIOS[PICOLAB_NUM_ANALOG_CHANNELS] = {26, 27, 28, PICOLAB_UNUSED_PIN};
#define PICOLAB_ADC_ACTIVE_CHANNELS 3
#define PICOLAB_ADC_FULL_SCALE_V 3.3f

#define PICOLAB_HAS_ADJ_RAIL 0
#define PICOLAB_RAIL_I2C_ID i2c1
#define PICOLAB_RAIL_I2C_SDA_PIN PICOLAB_UNUSED_PIN
#define PICOLAB_RAIL_I2C_SCL_PIN PICOLAB_UNUSED_PIN
#define PICOLAB_RAIL_I2C_BAUD_HZ 400000u
#define PICOLAB_RAIL_I2C_ADDR 0x60u
#define PICOLAB_RAIL_EN_PIN PICOLAB_UNUSED_PIN
#define PICOLAB_RAIL_ALT_PIN PICOLAB_UNUSED_PIN
#define PICOLAB_RAIL_VOUT_MIN_MV 1000u
#define PICOLAB_RAIL_VOUT_MAX_MV 12000u
#define PICOLAB_RAIL_FB_GAIN 12.0f

#define PICOLAB_HAS_NEOPIXEL 0
#define PICOLAB_NEOPIXEL_PIN PICOLAB_UNUSED_PIN

#define PICOLAB_HAS_BOOTSEL_BUTTON 0
#define PICOLAB_BOOTSEL_BUTTON_PIN PICOLAB_UNUSED_PIN
#define PICOLAB_BOOTSEL_BUTTON_ACTIVE_LEVEL 0

#elif PICOLAB_HW_TARGET == HW_PICOLAB_REV1

#define PICOLAB_BOARD_NAME "PicoLab Rev 1"

// D0..D7 map to IO_D1..IO_D8 on custom hardware.
static const uint8_t PICOLAB_MANAGED_PINS[PICOLAB_NUM_DIGITAL_PINS] = {14, 10, 32, 33, 11, 29, 30, 7};
static const uint8_t PICOLAB_DIR_CTRL_PINS[PICOLAB_NUM_DIGITAL_PINS] = {13, 8, 31, 12, 9, 28, 34, 35};
static const uint8_t PICOLAB_PULLUP_CTRL_PINS[PICOLAB_NUM_DIGITAL_PINS] = {16, 17, 18, 19, 21, 22, 23, 24};

#define PICOLAB_HAS_EXT_DIR_CTRL 1
#define PICOLAB_HAS_EXT_PULLUP_CTRL 1
#define PICOLAB_DIR_OUT_LEVEL 1
#define PICOLAB_PULLUP_ENABLE_LEVEL 1
#define PICOLAB_LOGIC_BASE_PIN 14

#define PICOLAB_UART_ID uart1
#define PICOLAB_UART_TX_PIN 36
#define PICOLAB_UART_RX_PIN 37
#define PICOLAB_UART_BAUD_RATE 115200

#define PICOLAB_SPI_ID spi0
#define PICOLAB_SPI_SCK_PIN 2
#define PICOLAB_SPI_MOSI_PIN 3
#define PICOLAB_SPI_MISO_PIN 0
#define PICOLAB_SPI_DEFAULT_CS_PIN 1

#define PICOLAB_I2C0_ID i2c0
#define PICOLAB_I2C0_SDA_PIN 4
#define PICOLAB_I2C0_SCL_PIN 5

static const uint8_t PICOLAB_ADC_INPUTS[PICOLAB_NUM_ANALOG_CHANNELS] = {4, 5, 6, 7};
static const uint8_t PICOLAB_ADC_GPIOS[PICOLAB_NUM_ANALOG_CHANNELS] = {44, 45, 46, 47};
#define PICOLAB_ADC_ACTIVE_CHANNELS 4
#define PICOLAB_ADC_FULL_SCALE_V 11.1f
#define PSU_ADC_PIN_ADJ_I 40
#define PSU_ADC_PIN_3V3_I 41
#define PSU_ADC_PIN_5V_I  42
#define PSU_ADC_PIN_ADJ_V 43
#define PSU_SCALE_CURRENT 1.0f 
#define PSU_SCALE_VOLTAGE 3.70f

#define PICOLAB_HAS_ADJ_RAIL 1
#define PICOLAB_RAIL_I2C_ID i2c1
#define PICOLAB_RAIL_I2C_SDA_PIN 26
#define PICOLAB_RAIL_I2C_SCL_PIN 27
#define PICOLAB_RAIL_I2C_BAUD_HZ 400000u
#define PICOLAB_RAIL_I2C_ADDR 0x60u
#define PICOLAB_RAIL_EN_PIN 15
#define PICOLAB_RAIL_ALT_PIN 25
#define PICOLAB_RAIL_VOUT_MIN_MV 500u
#define PICOLAB_RAIL_VOUT_MAX_MV 5150u
#define PICOLAB_RAIL_FB_GAIN 3.15f

#define PICOLAB_HAS_NEOPIXEL 1
#define PICOLAB_NEOPIXEL_PIN 20

#define PICOLAB_HAS_BOOTSEL_BUTTON 1
#define PICOLAB_BOOTSEL_BUTTON_PIN 6
#define PICOLAB_BOOTSEL_BUTTON_ACTIVE_LEVEL 0

#elif PICOLAB_HW_TARGET == HW_PICOLAB_REV2

#define PICOLAB_BOARD_NAME "PicoLab Rev 2"

// D0..D7 map to IO_D1..IO_D8 on custom hardware.
static const uint8_t PICOLAB_MANAGED_PINS[PICOLAB_NUM_DIGITAL_PINS] = {14, 11, 12, 9, 13, 10, 8, 7};
static const uint8_t PICOLAB_DIR_CTRL_PINS[PICOLAB_NUM_DIGITAL_PINS] = {29, 30, 31, 32, 33, 28, 34, 35};
static const uint8_t PICOLAB_PULLUP_CTRL_PINS[PICOLAB_NUM_DIGITAL_PINS] = {16, 17, 18, 19, 21, 22, 23, 24};

#define PICOLAB_HAS_EXT_DIR_CTRL 1
#define PICOLAB_HAS_EXT_PULLUP_CTRL 1
#define PICOLAB_DIR_OUT_LEVEL 1
#define PICOLAB_PULLUP_ENABLE_LEVEL 1
#define PICOLAB_LOGIC_BASE_PIN 7

#define PICOLAB_UART_ID uart1
#define PICOLAB_UART_TX_PIN 36
#define PICOLAB_UART_RX_PIN 37
#define PICOLAB_UART_BAUD_RATE 115200

#define PICOLAB_SPI_ID spi0
#define PICOLAB_SPI_SCK_PIN 2
#define PICOLAB_SPI_MOSI_PIN 3
#define PICOLAB_SPI_MISO_PIN 0
#define PICOLAB_SPI_DEFAULT_CS_PIN 1

#define PICOLAB_I2C0_ID i2c0
#define PICOLAB_I2C0_SDA_PIN 4
#define PICOLAB_I2C0_SCL_PIN 5

static const uint8_t PICOLAB_ADC_INPUTS[PICOLAB_NUM_ANALOG_CHANNELS] = {4, 5, 6, 7};
static const uint8_t PICOLAB_ADC_GPIOS[PICOLAB_NUM_ANALOG_CHANNELS] = {44, 45, 46, 47};
#define PICOLAB_ADC_ACTIVE_CHANNELS 4
#define PICOLAB_ADC_FULL_SCALE_V 11.1f
#define PSU_ADC_PIN_ADJ_I 40
#define PSU_ADC_PIN_3V3_I 41
#define PSU_ADC_PIN_5V_I  42
#define PSU_ADC_PIN_ADJ_V 43
#define PSU_SCALE_CURRENT 1.0f 
#define PSU_SCALE_VOLTAGE 3.70f

#define PICOLAB_HAS_ADJ_RAIL 1
#define PICOLAB_RAIL_I2C_ID i2c1
#define PICOLAB_RAIL_I2C_SDA_PIN 26
#define PICOLAB_RAIL_I2C_SCL_PIN 27
#define PICOLAB_RAIL_I2C_BAUD_HZ 400000u
#define PICOLAB_RAIL_I2C_ADDR 0x60u
#define PICOLAB_RAIL_EN_PIN 15
#define PICOLAB_RAIL_ALT_PIN 25
#define PICOLAB_RAIL_VOUT_MIN_MV 500u
#define PICOLAB_RAIL_VOUT_MAX_MV 5150u
#define PICOLAB_RAIL_FB_GAIN 3.15f

#define PICOLAB_HAS_NEOPIXEL 1
#define PICOLAB_NEOPIXEL_PIN 20

#define PICOLAB_HAS_BOOTSEL_BUTTON 1
#define PICOLAB_BOOTSEL_BUTTON_PIN 6
#define PICOLAB_BOOTSEL_BUTTON_ACTIVE_LEVEL 0

#else
#error "Unsupported PICOLAB_HW_TARGET"
#endif

#if PICOLAB_HAS_NEOPIXEL
#ifndef PICO_DEFAULT_WS2812_PIN
#define PICO_DEFAULT_WS2812_PIN PICOLAB_NEOPIXEL_PIN
#endif
#define PICO_COLORED_STATUS_LED_AVAILABLE 1
#else
#define PICO_COLORED_STATUS_LED_AVAILABLE 0
#endif

#ifndef PICO_STATUS_LED_AVAILABLE
#define PICO_STATUS_LED_AVAILABLE 0
#endif

#endif
